jamesvici/lumenpnp-feeder/pcb/mobo/mobo.kicad_pcb

## KiCad design pcb/mobo/mobo.kicad_pcb (2025-03-26)

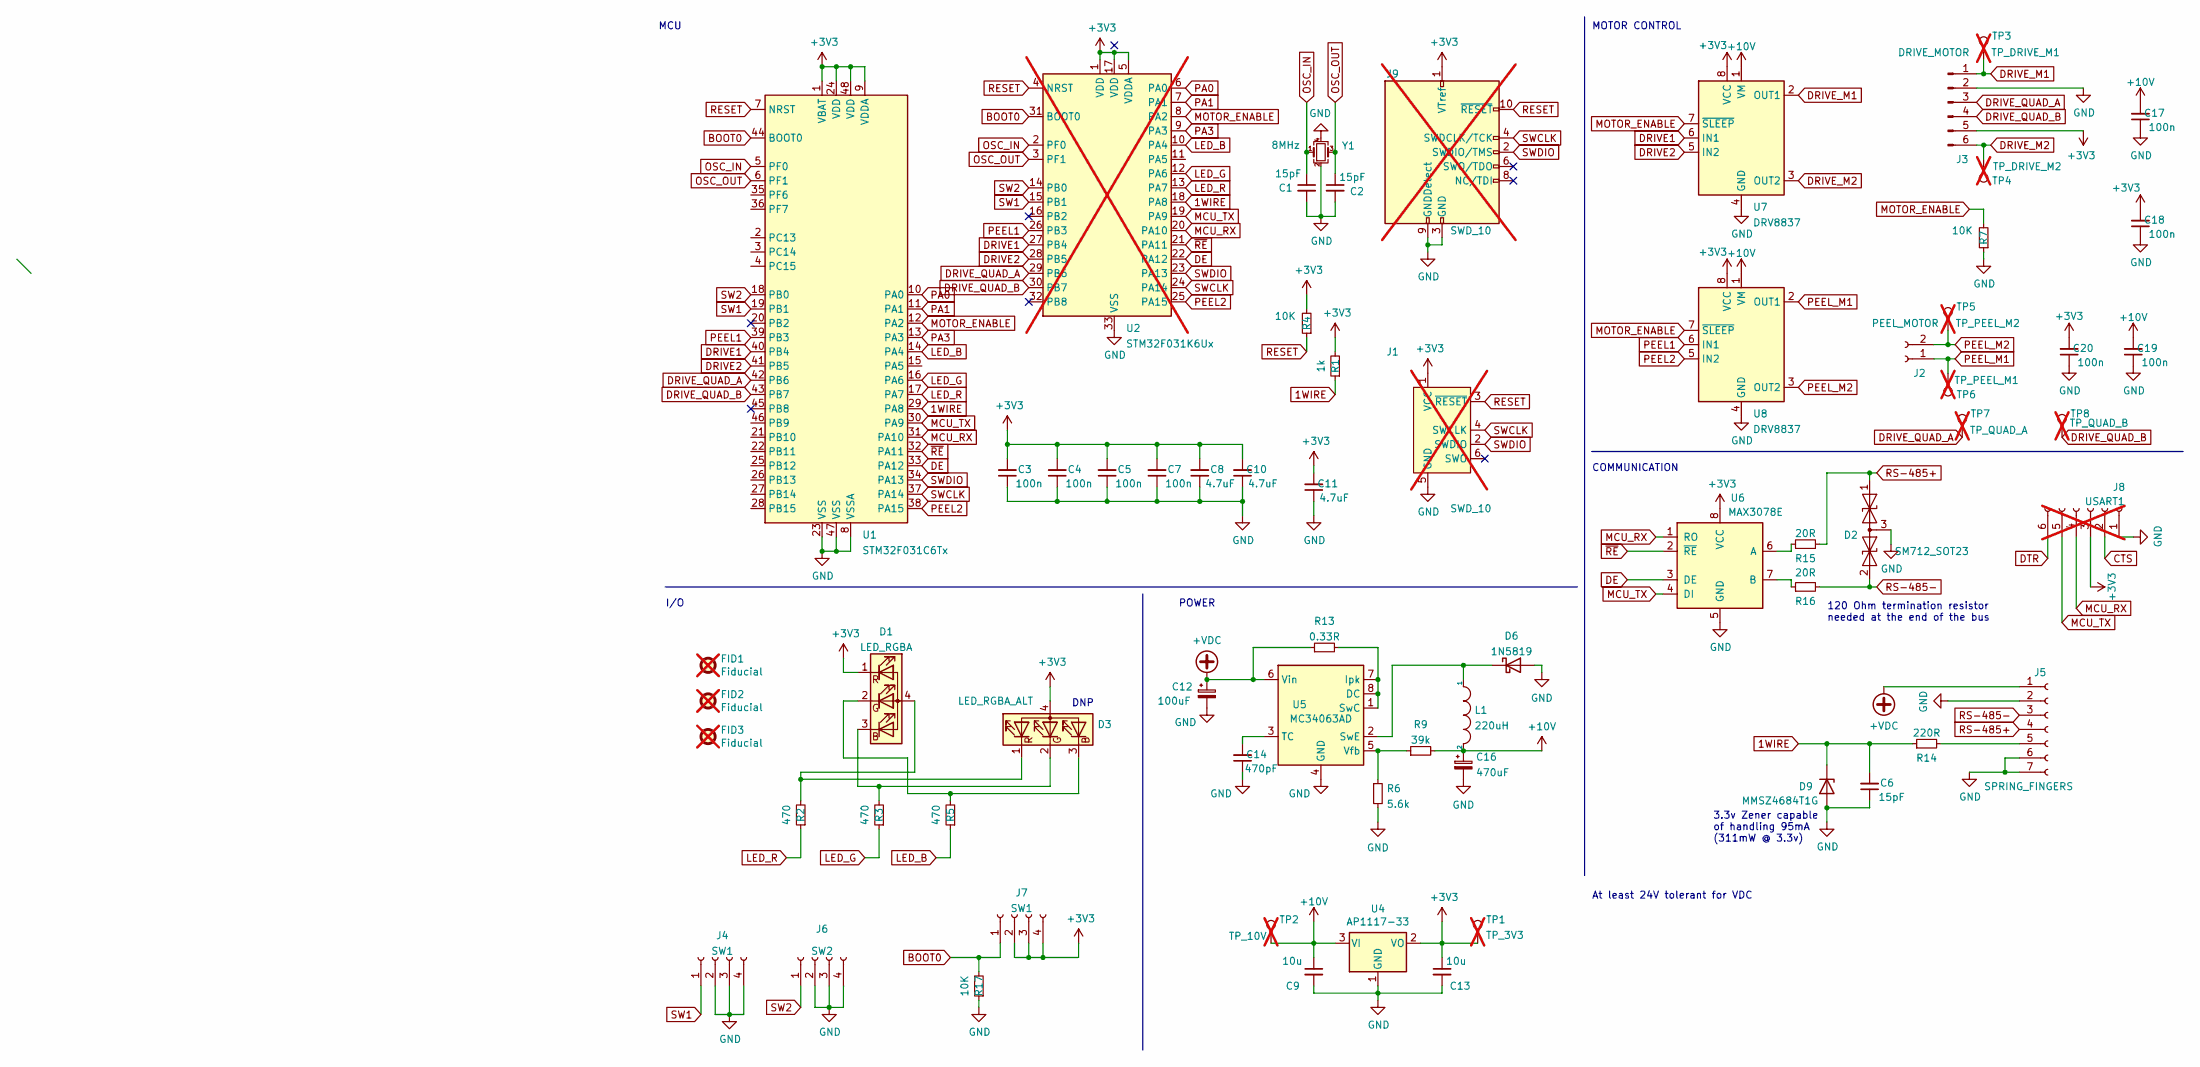
[picture p1: schematic mobo.kicad_sch, LumenPnP Feeder Control Board]

Parts:
C1, C2, C6: 15pF; C_0805_2012Metric; LCSC C527077
C3, C4, C5, C7, C17, C18, C19, C20: 100n; C_0805_2012Metric; LCSC C476766
C8, C10, C11: 4.7uF; C_0805_2012Metric; LCSC C1779
C9, C13: 10u; C_0805_2012Metric; LCSC C15850
C12: 100uF; C_Elec_6.3x7.7; LCSC C178512
C14: 470pF; C_0805_2012Metric; LCSC C1743
C16: 470uF; C_Elec_8x6.2; LCSC C5354997
D1: LED_RGBA; MHS110FRGBCT; DigiKey 732-11414-1-ND
D2: SM712_SOT23; SOT-23; LCSC C521963
D3: LED_RGBA_ALT; LED_LiteOn_LTST-C19HE1WT; LCSC C458749
D6: 1N5819; D_SOD-323_HandSoldering; DigiKey 1655-1N5819WCT-ND
D9: MMSZ4684T1G; D_SOD-123; DigiKey MMSZ4684T1GOSCT-ND
FID1, FID2, FID3: Fiducial; Fiducial_1mm_Mask2mm; not fitted
J1: SWD_10; Tag-Connect_TC2030-IDC-FP_2x03_P1.27mm_Vertical; not fitted
J2: PEEL_MOTOR; Molex_PicoBlade_53261-0271_1x02-1MP_P1.25mm_Horizontal; LCSC C2845379
J3: DRIVE_MOTOR; Molex_PicoBlade_53261-0671_1x06-1MP_P1.25mm_Horizontal; LCSC C2845383
J4, J7: SW1; 1TS003B-1400-3500A-CT; LCSC C319392
J5: SPRING_FINGERS; AVX-9155-005-541; DigiKey 478-5453-1-ND
J6: SW2; 1TS003B-1400-3500A-CT; LCSC C319392
J8: USART1; UART_FRICTION_FIT; not fitted
J9: SWD_10; PinHeader_2x05_P1.27mm_Vertical_SMD; DigiKey 1528-5434-ND; not fitted
L1: 220uH; L_6.3x6.3_H3; LCSC C5127556
R1: 1k; R_0805_2012Metric; LCSC C17513
R2, R3, R5: 470; R_0805_2012Metric; LCSC C119076
R4, R7, R17: 10K; R_0805_2012Metric; LCSC C84376
R6: 5.6k; R_0805_2012Metric; LCSC C4382
R9: 39k; R_0805_2012Metric; LCSC C113306
R13: 0.33R; R_0805_2012Metric; DigiKey 13-RT0805FRE0733RLCT-ND
R14: 220R; R_0805_2012Metric; DigiKey 13-RT0805FRE07220RLCT-ND
R15, R16: 20R; R_0805_2012Metric; DigiKey 311-20.0CRCT-ND
TP1: TP_3V3; TestPoint_Pad_D2.0mm; not fitted
TP2: TP_10V; TestPoint_Pad_D2.0mm; not fitted
TP3: TP_DRIVE_M1; TestPoint_Pad_D2.0mm; not fitted
TP4: TP_DRIVE_M2; TestPoint_Pad_D2.0mm; not fitted
TP5: TP_PEEL_M2; TestPoint_Pad_D2.0mm; not fitted
TP6: TP_PEEL_M1; TestPoint_Pad_D2.0mm; not fitted
TP7: TP_QUAD_A; TestPoint_Pad_D2.0mm; not fitted
TP8: TP_QUAD_B; TestPoint_Pad_D2.0mm; not fitted
U1: STM32F031C6Tx; LQFP-48_7x7mm_P0.5mm; LCSC C329281
U2: STM32F031K6Ux; QFN-32-1EP_5x5mm_P0.5mm_EP3.45x3.45mm; not fitted
U4: AP1117-33; SOT-223-3_TabPin2; LCSC C5250992
U5: MC34063AD; SOIC-8_3.9x4.9mm_P1.27mm; LCSC C100023
U6: MAX3078E; SOIC-8_3.9x4.9mm_P1.27mm; LCSC C336020
U7, U8: DRV8837; WSON-8-1EP_2x2mm_P0.5mm_EP0.9x1.6mm; DigiKey 296-34806-1-ND
Y1: 8MHz; Crystal_SMD_3225-4Pin_3.2x2.5mm_HandSoldering; LCSC C5308002

Connections:
1WIRE: C6.2, D9.1 (K), R1.1, R14.1, U1.29 (PA8), U2.18 (PA8)
+3V3: C3.2, C4.2, C5.2, C7.2, C8.2, C10.2, C11.2, C13.1, C18.2, C20.2, D1.1 (RK), D3.4 (A), J1.1 (VCC), J3.5, J7.2, J7.3, J7.4, J8.3, J9.1 (VTref), R1.2, R4.2, TP1.1, U1.1 (VBAT), U1.9 (VDDA), U1.24 (VDD), U1.48 (VDD), U2.1 (VDD), U2.5 (VDDA), U2.17 (VDD), U4.2 (VO), U6.8 (VCC), U7.8 (VCC), U8.8 (VCC)
+10V: C9.1, C16.1, C17.2, C19.2, L1.2, R9.2, TP2.1, U4.3 (VI), U7.1 (VM), U8.1 (VM)
+VDC: C12.1, J5.1, R13.1, U5.6 (Vin)
BOOT0: J7.1, R17.2, U1.44 (BOOT0), U2.31 (BOOT0)
CTS: J8.2
DE: U1.33 (PA12), U2.22 (PA12), U6.3 (DE)
DRIVE1: U1.40 (PB4), U2.27 (PB4), U7.6 (IN1)
DRIVE2: U1.41 (PB5), U2.28 (PB5), U7.5 (IN2)
DRIVE_M1: J3.1, TP3.1, U7.2 (OUT1)
DRIVE_M2: J3.6, TP4.1, U7.3 (OUT2)
DRIVE_QUAD_A: J3.3, TP7.1, U1.42 (PB6), U2.29 (PB6)
DRIVE_QUAD_B: J3.4, TP8.1, U1.43 (PB7), U2.30 (PB7)
DTR: J8.6
GND: C1.2, C2.2, C3.1, C4.1, C5.1, C6.1, C7.1, C8.1, C9.2, C10.1, C11.1, C12.2, C13.2, C14.1, C16.2, C17.1, C18.1, C19.1, C20.1, D2.3 (common), D6.2 (A), D9.2 (A), J1.5 (GND), J3.2, J4.2, J4.3, J4.4, J5.2, J5.6, J5.7, J6.2, J6.3, J6.4, J8.1, J9.3 (GND), J9.5 (GND), J9.9 (GNDDetect), R6.2, R7.1, R17.1, U1.8 (VSSA), U1.23 (VSS), U1.47 (VSS), U2.33 (VSS), U4.1 (GND), U5.4 (GND), U6.5 (GND), U7.4 (GND), U7.9 (GND), U8.4 (GND), U8.9 (GND), Y1.2, Y1.4
LED_B: R5.1, U1.14 (PA4), U2.10 (PA4)
LED_G: R3.1, U1.16 (PA6), U2.12 (PA6)
LED_R: R2.1, U1.17 (PA7), U2.13 (PA7)
MCU_RX: J8.4, U1.31 (PA10), U2.20 (PA10), U6.1 (RO)
MCU_TX: J8.5, U1.30 (PA9), U2.19 (PA9), U6.4 (DI)
MOTOR_ENABLE: R7.2, U1.12 (PA2), U2.8 (PA2), U7.7 (~SLEEP), U8.7 (~SLEEP)
unnamed: D1.4 (A), D3.1 (RK), R2.2
unnamed: D1.3 (BK), D3.2 (GK), R3.2
unnamed: D1.2 (GK), D3.3 (BK), R5.2
unnamed: D6.1 (K), L1.1, U5.2 (SwE)
unnamed: J5.5, R14.2
unnamed: R13.2, U5.1 (SwC), U5.7 (Ipk), U5.8 (DC)
unnamed: C14.2, U5.3 (TC)
unnamed: R6.1, R9.1, U5.5 (Vfb)
unnamed: R15.1, U6.6 (A)
unnamed: R16.1, U6.7 (B)
OSC_IN: C1.1, U1.5 (PF0), U2.2 (PF0), Y1.1
OSC_OUT: C2.1, U1.6 (PF1), U2.3 (PF1), Y1.3
PA0: U1.10 (PA0), U2.6 (PA0)
PA1: U1.11 (PA1), U2.7 (PA1)
PA3: U1.13 (PA3), U2.9 (PA3)
PEEL1: U1.39 (PB3), U2.26 (PB3), U8.6 (IN1)
PEEL2: U1.38 (PA15), U2.25 (PA15), U8.5 (IN2)
PEEL_M1: J2.1, TP6.1, U8.2 (OUT1)
PEEL_M2: J2.2, TP5.1, U8.3 (OUT2)
RESET: J1.3 (~RESET), J9.10 (~RESET), R4.1, U1.7 (NRST), U2.4 (NRST)
RS-485+: D2.1 (A1), J5.4, R15.2
RS-485-: D2.2 (A2), J5.3, R16.2
SW1: J4.1, U1.19 (PB1), U2.15 (PB1)
SW2: J6.1, U1.18 (PB0), U2.14 (PB0)
SWCLK: J1.4 (SWCLK), J9.4 (SWDCLK/TCK), U1.37 (PA14), U2.24 (PA14)
SWDIO: J1.2 (SWDIO), J9.2 (SWDIO/TMS), U1.34 (PA13), U2.23 (PA13)
~RE: U1.32 (PA11), U2.21 (PA11), U6.2 (~RE)

Notes on the sheet:
I/O
DNP
COMMUNICATION
MOTOR CONTROL
POWER
3.3v Zener capable of handling 95mA (311mW @ 3.3v)
At least 24V tolerant for VDC
MCU
120 Ohm termination resistor needed at the end of the bus

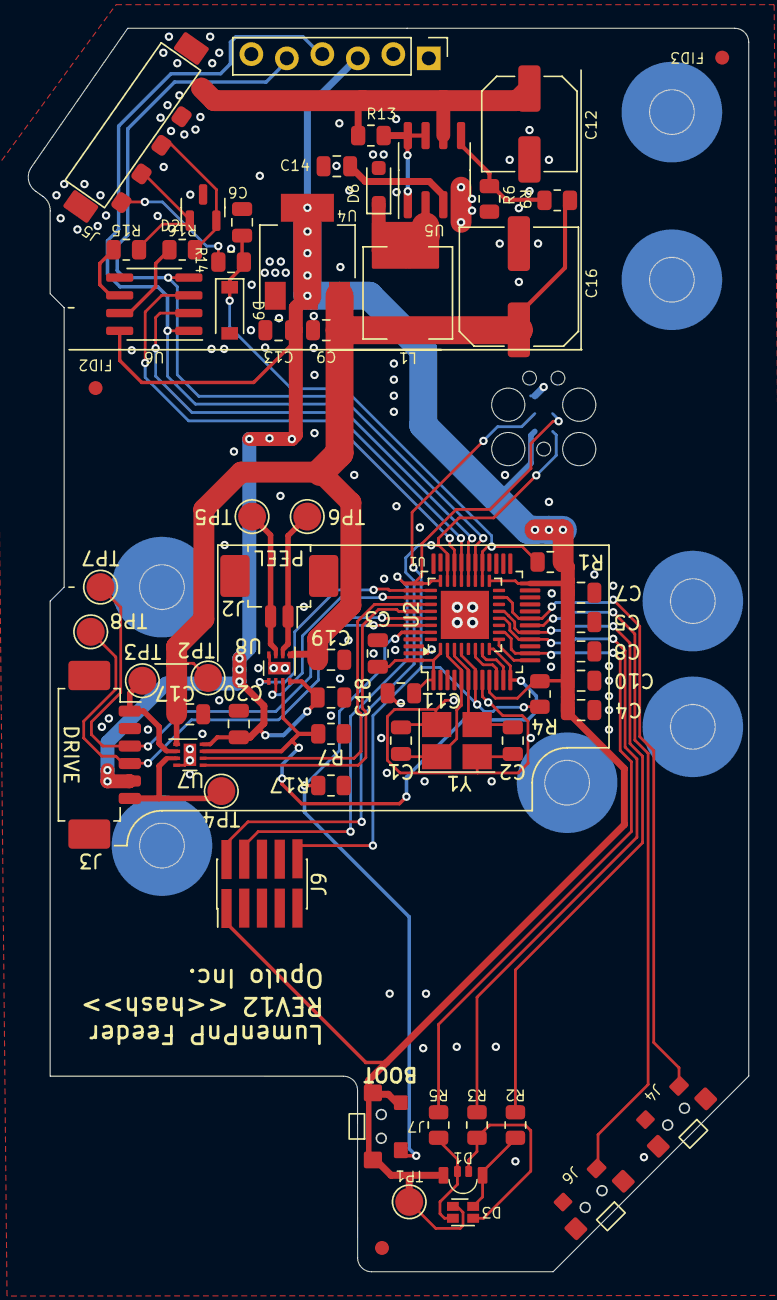
[picture p2: board mobo.kicad_pcb from above]

Board: 2 copper layers, 51.6 x 89.0 mm, 66 parts (1 on the bottom side), 46 nets.
