jamesvici/lumenpnp-feeder/(commit log)

2025-02-14 updates asm to show latest frame changes
2025-03-15 Change 470uF electrolytic from 6.3mm to 8mm so there are more options available; Add LCSC, Mouser, and DigiKey reference parts.
    [mobo.kicad_pcb, mobo.kicad_sch]
2025-03-17 Invalid LCSC part for crystal, changed to C527077
    [mobo.kicad_pcb, mobo.kicad_sch]
2025-03-17 Convert SWD connector on back to TC2030. Left one on front for Adafruit 5434 connector.
    [mobo.kicad_pcb, mobo.kicad_sch]
2025-03-26 Modify SWD footprint to make compatible with Adafruit 5434
    [mobo.kicad_pcb, mobo.kicad_sch]
